galopago/PANEL_MOUNT_7_SEGMENTS_DISPLAY/README.md

# PANEL MOUNT 7 SEGMENT SERIALLY CONTROLED LED DISPLAYS

Open source 7 segment serially controlled led display that fits inside a generic 45x26mm panel mount plastic enclosure. Upgrade your function specific panel meter PCB with a new one controllable by your preferred MCU.

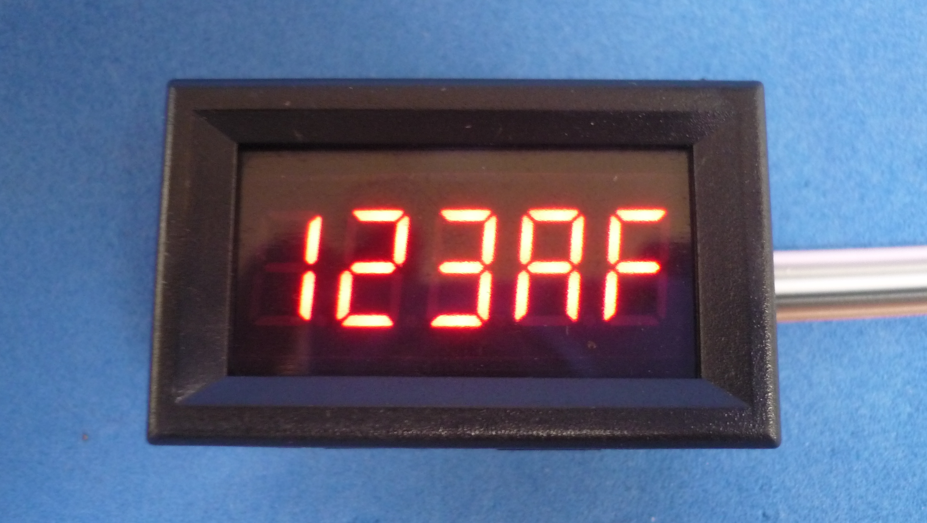
[picture p1: 036-inch-5-digit/assets/img/meteron.jpg]
METERON


Read this in other languages: [Español](/assets/markdown/README.es.md)

Upgrading a 5 digit voltmeter PCB with a 5 digit serially controllable display

0.36 Inch 5 Digits voltmeter                  | 0.36 Inch 5 Digits serially controllable     
----------------------------------------------|----------------------------------------------
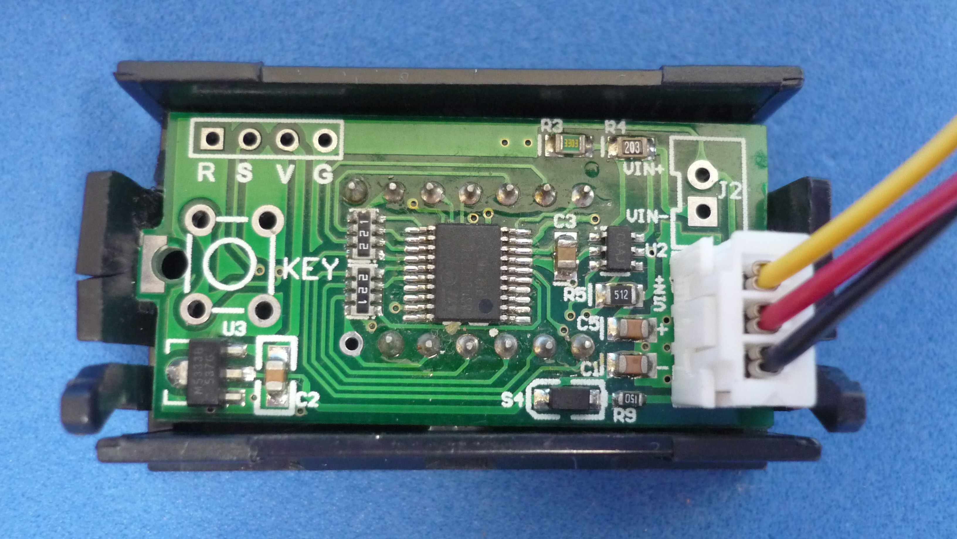
[picture p2: assets/img/voltmeterback.jpg]
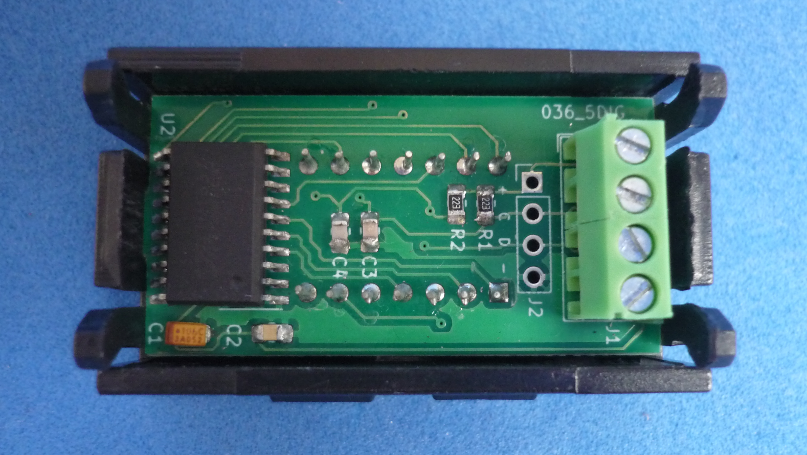
[picture p3: 036-inch-5-digit/assets/img/meterback.jpg]
            | 
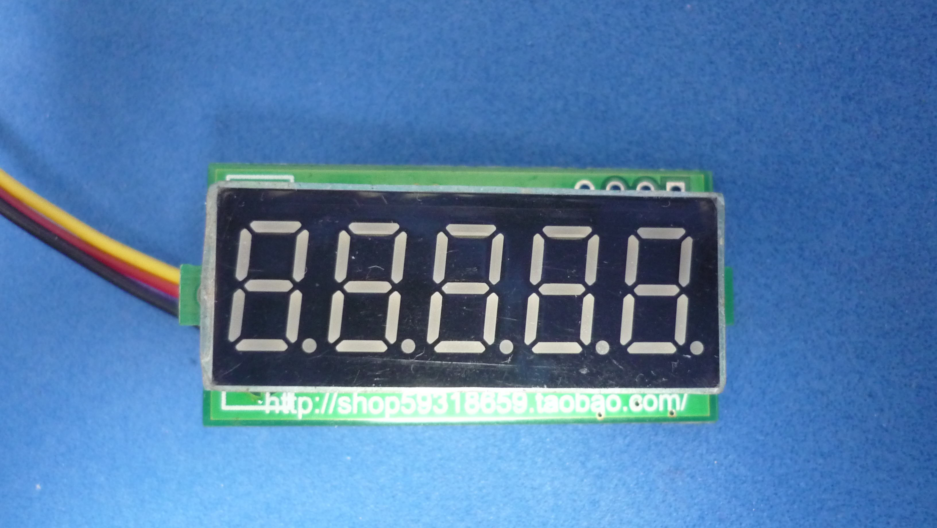
[picture p4: assets/img/voltmeterpcbfront.jpg]
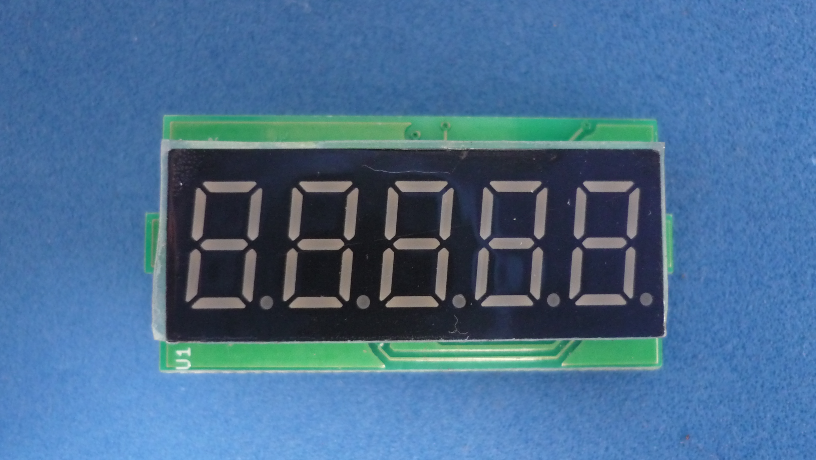
[picture p5: 036-inch-5-digit/assets/img/pcbfront.jpg]
        | 
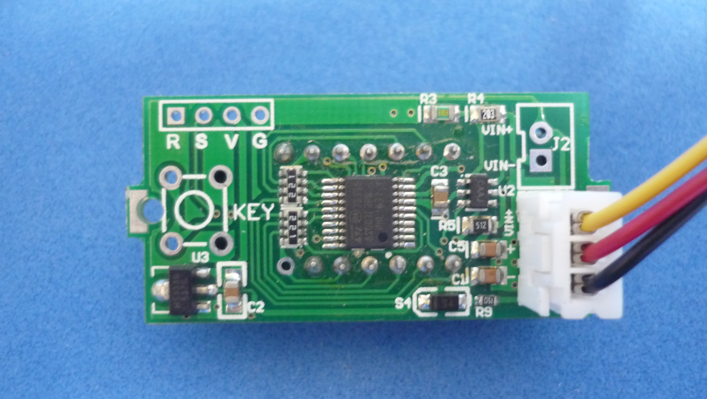
[picture p6: assets/img/voltmeterpcbback.jpg]
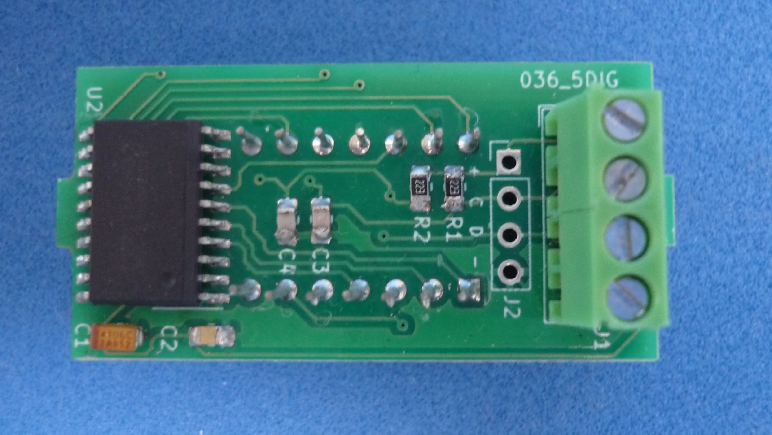
[picture p7: 036-inch-5-digit/assets/img/pcbback.jpg]
         | 

The display can be now controlled by Arduino (or any other) boards via serial bus, to display numbers, letters, or individual segments.

## Versions

There are several board versions, each one with different personalities

| HINT | CONTROLLER CHIP | LINK 
|---|---|---
| 056 INCH 3 DIGIT | TM1637 | [056 INCH 3 DIGIT](/056-inch-3-digit)  
| 036 INCH 5 DIGIT | TM1637 | [036 INCH 5 DIGIT](/036-inch-5-digit)  
| 028 INCH 8 DIGIT (2 Lines x 4Digit)| MAX7219 | [028 INCH 8 DIGIT](/028-inch-8-digit)

0.56 Inch 3 Digits                            | 0.36 Inch 5 Digits                            | 0.28 Inch 8 Digits 
----------------------------------------------|-----------------------------------------------|----------------------------------------------
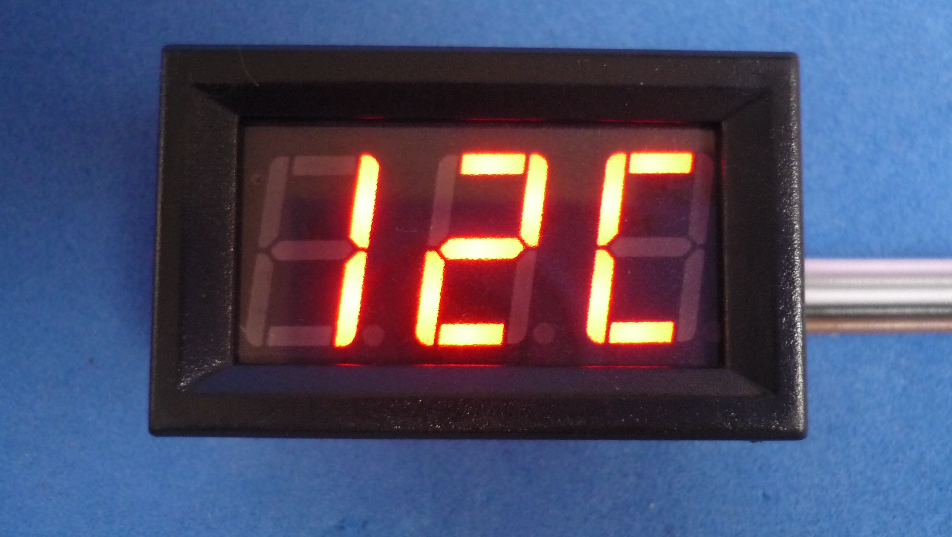
[picture p8: 056-inch-3-digit/assets/img/meteron.jpg]
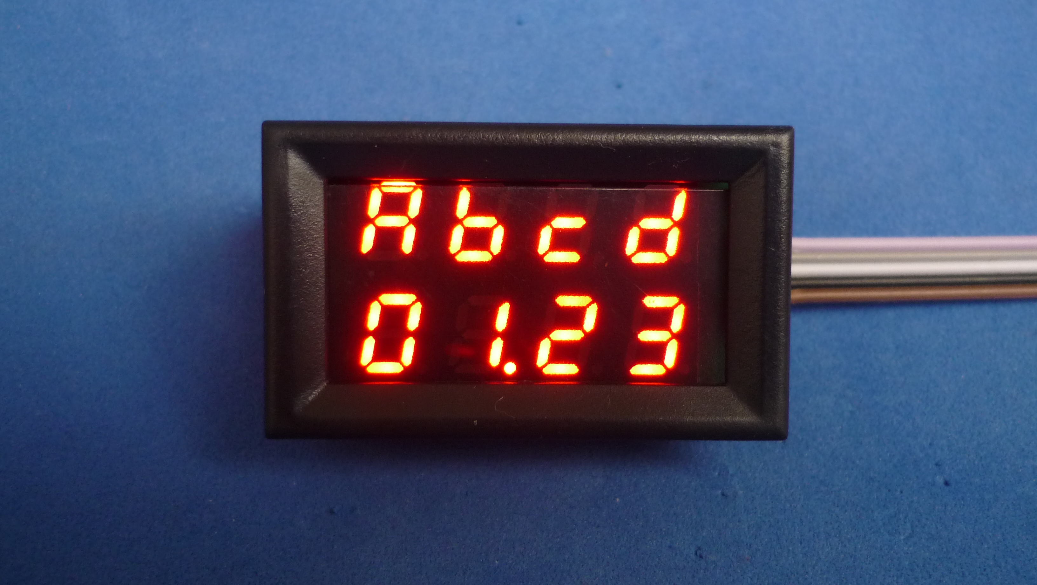
[picture p9: 028-inch-8-digit/assets/img/meteron.jpg]
 |  |
