galopago/PANEL_MOUNT_7_SEGMENTS_DISPLAY/028-inch-8-digit/assets/img/meterback.jpg

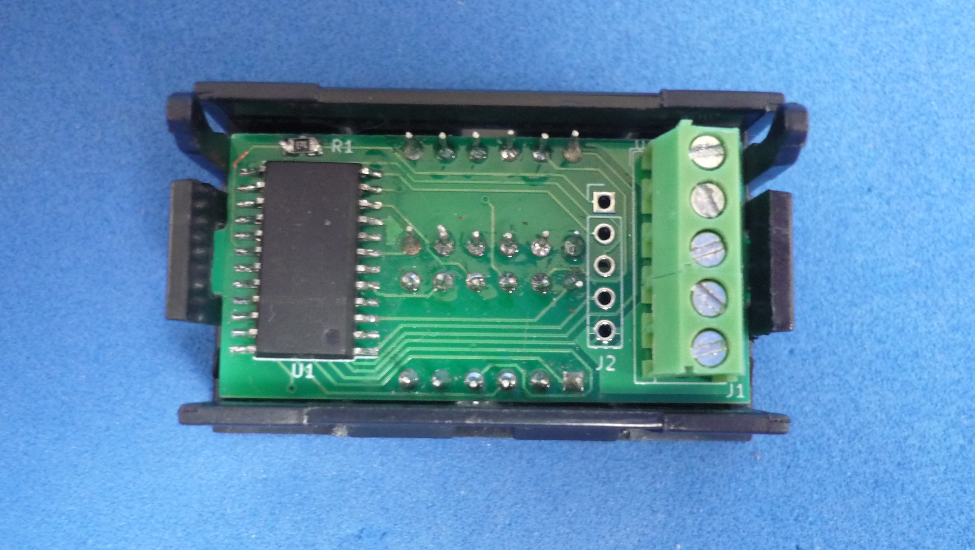
028-inch-8-digit/assets/img/meterback.jpg
