galopago/PANEL_MOUNT_7_SEGMENTS_DISPLAY/036-inch-5-digit/assets/img/meterfront.jpg

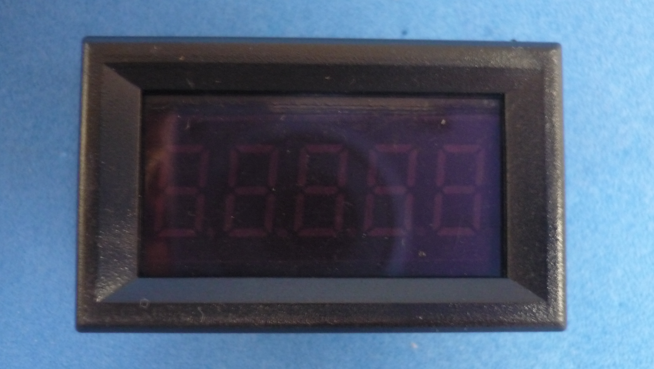
036-inch-5-digit/assets/img/meterfront.jpg
