galopago/PANEL_MOUNT_7_SEGMENTS_DISPLAY/056-inch-3-digit/assets/img/meterback.jpg

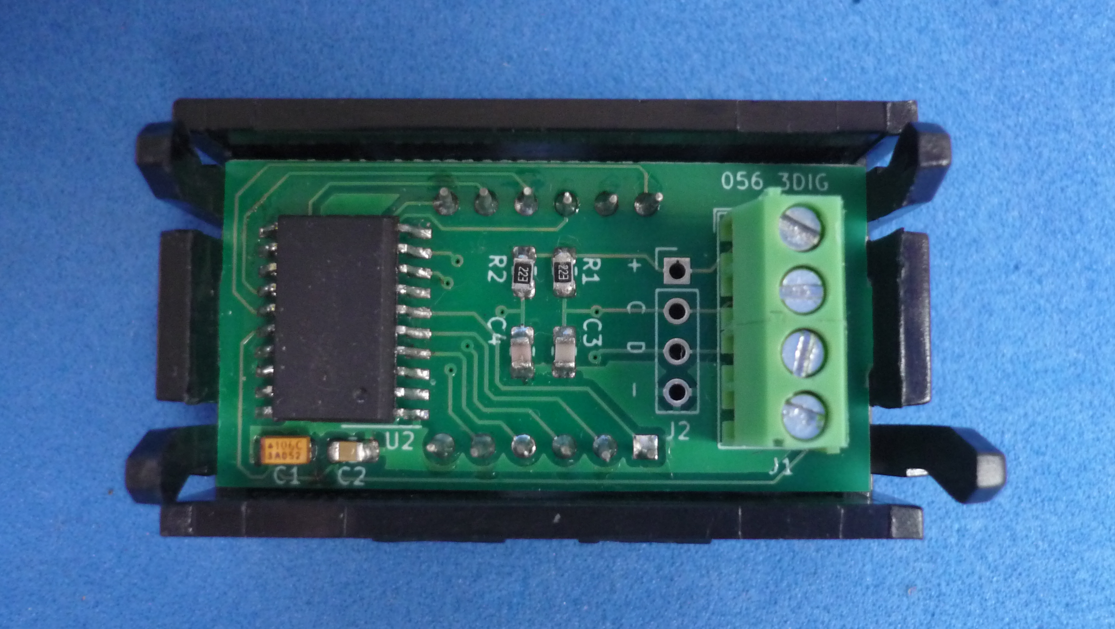
056-inch-3-digit/assets/img/meterback.jpg
