galopago/PANEL_MOUNT_7_SEGMENTS_DISPLAY/(list of files, drawings)

Other design files:
028-inch-8-digit/routing/028INCH_8DIGIT.dsn
