galopago/PANEL_MOUNT_7_SEGMENTS_DISPLAY/028-inch-8-digit/028INCH_8DIGIT.kicad_pcb

## KiCad design 028-inch-8-digit/028INCH_8DIGIT.kicad_pcb (2021-11-16)

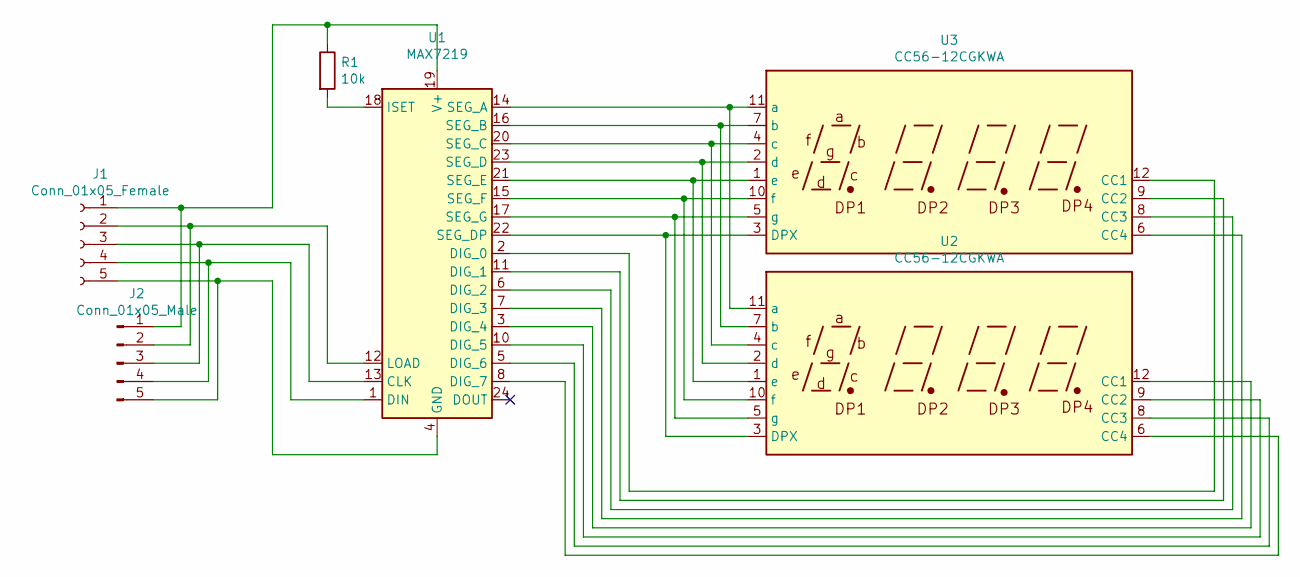
[picture p22: schematic 028INCH_8DIGIT.sch]

Parts:
J1: Conn_01x05_Female; TerminalBlock_4Ucon_1x05_P3.50mm_Horizontal
J2: Conn_01x05_Male; PinHeader_1x05_P2.54mm_Vertical
R1: 10k; R_0805_2012Metric_Pad1.15x1.40mm_HandSolder
U1: MAX7219; SOIC-24W_7.5x15.4mm_P1.27mm
U2, U3: CC56-12CGKWA; 2841AS

Connections:
unnamed: J1.1, J2.1, R1.1, U1.19 (V+)
unnamed: J1.2, J2.2, U1.12 (LOAD)
unnamed: J1.3, J2.3, U1.13 (CLK)
unnamed: J1.4, J2.4, U1.1 (DIN)
unnamed: J1.5, J2.5, U1.4 (GND), U1.9 (GND)
unnamed: R1.2, U1.18 (ISET)
unnamed: U1.2 (DIG_0), U3.12 (CC1)
unnamed: U1.3 (DIG_4), U2.12 (CC1)
unnamed: U1.5 (DIG_6), U2.8 (CC3)
unnamed: U1.6 (DIG_2), U3.8 (CC3)
unnamed: U1.7 (DIG_3), U3.6 (CC4)
unnamed: U1.8 (DIG_7), U2.6 (CC4)
unnamed: U1.10 (DIG_5), U2.9 (CC2)
unnamed: U1.11 (DIG_1), U3.9 (CC2)
unnamed: U1.14 (SEG_A), U2.11 (a), U3.11 (a)
unnamed: U1.15 (SEG_F), U2.10 (f), U3.10 (f)
unnamed: U1.16 (SEG_B), U2.7 (b), U3.7 (b)
unnamed: U1.17 (SEG_G), U2.5 (g), U3.5 (g)
unnamed: U1.20 (SEG_C), U2.4 (c), U3.4 (c)
unnamed: U1.21 (SEG_E), U2.1 (e), U3.1 (e)
unnamed: U1.22 (SEG_DP), U2.3 (DPX), U3.3 (DPX)
unnamed: U1.23 (SEG_D), U2.2 (d), U3.2 (d)

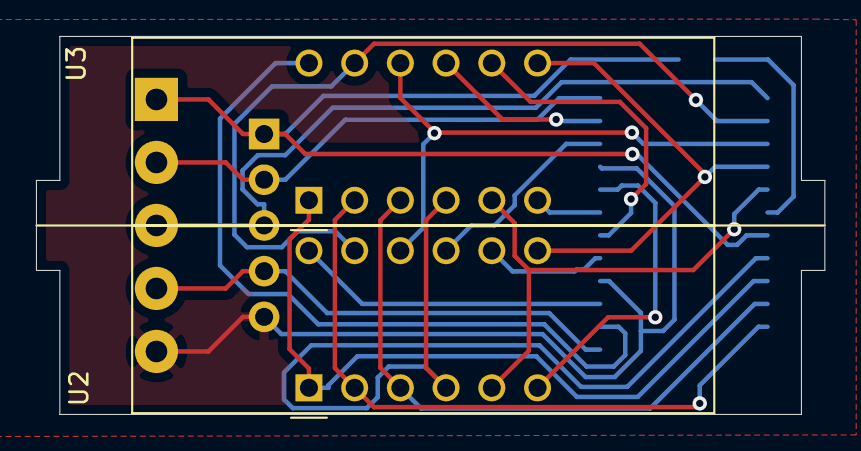
[picture p23: board 028INCH_8DIGIT.kicad_pcb from above]

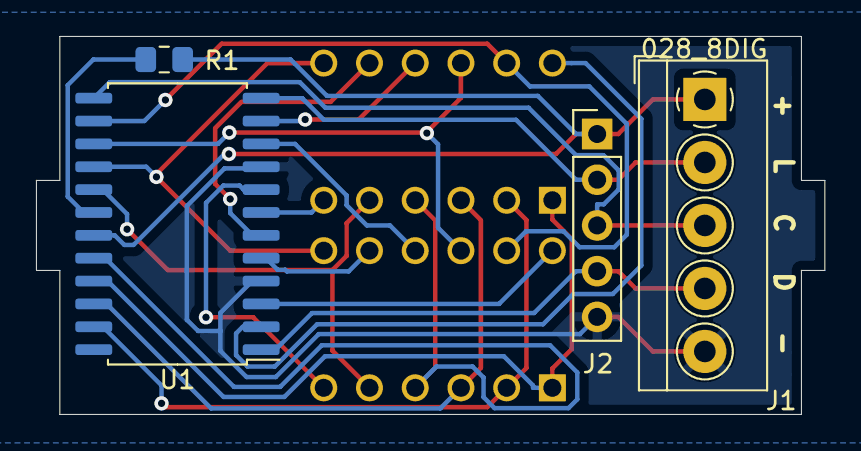
[picture p24: board 028INCH_8DIGIT.kicad_pcb from below]

Board: 2 copper layers, 43.8 x 21.0 mm, 6 parts (4 on the bottom side), 22 nets.
