galopago/PANEL_MOUNT_7_SEGMENTS_DISPLAY/036-inch-5-digit/036INCH_5DIGIT.kicad_pcb

## KiCad design 036-inch-5-digit/036INCH_5DIGIT.kicad_pcb (2021-11-16)

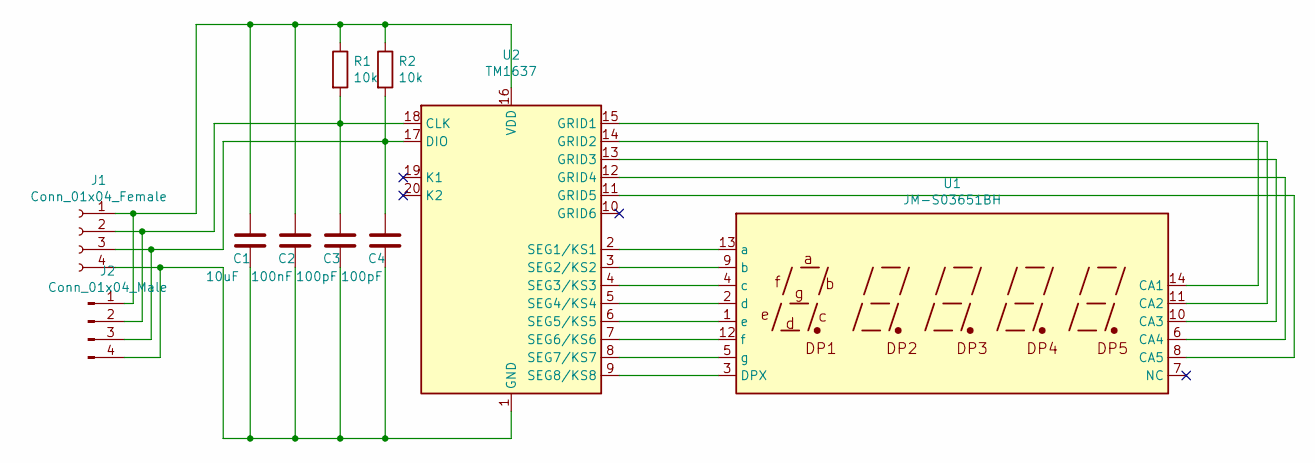
[picture p25: schematic 036INCH_5DIGIT.sch]

Parts:
C1: 10uF; C_0805_2012Metric_Pad1.15x1.40mm_HandSolder
C2: 100nF; C_0805_2012Metric_Pad1.15x1.40mm_HandSolder
C3, C4: 100pF; C_0805_2012Metric_Pad1.15x1.40mm_HandSolder
J1: Conn_01x04_Female; TerminalBlock_4Ucon_1x04_P3.50mm_Horizontal
J2: Conn_01x04_Male; PinHeader_1x04_P2.54mm_Vertical
R1, R2: 10k; R_0805_2012Metric_Pad1.15x1.40mm_HandSolder
U1: JM-S03651BH
U2: TM1637; SO-20_12.8x7.5mm_P1.27mm

Connections:
unnamed: C1.1, C2.1, J1.1, J2.1, R1.1, R2.1, U2.16 (VDD)
unnamed: C1.2, C2.2, C3.2, C4.2, J1.4, J2.4, U2.1 (GND)
unnamed: C3.1, J1.2, J2.2, R1.2, U2.18 (CLK)
unnamed: C4.1, J1.3, J2.3, R2.2, U2.17 (DIO)
unnamed: U1.1 (e), U2.6 (SEG5/KS5)
unnamed: U1.2 (d), U2.5 (SEG4/KS4)
unnamed: U1.3 (DPX), U2.9 (SEG8/KS8)
unnamed: U1.4 (c), U2.4 (SEG3/KS3)
unnamed: U1.5 (g), U2.8 (SEG7/KS7)
unnamed: U1.6 (CA4), U2.12 (GRID4)
unnamed: U1.8 (CA5), U2.11 (GRID5)
unnamed: U1.9 (b), U2.3 (SEG2/KS2)
unnamed: U1.10 (CA3), U2.13 (GRID3)
unnamed: U1.11 (CA2), U2.14 (GRID2)
unnamed: U1.12 (f), U2.7 (SEG6/KS6)
unnamed: U1.13 (a), U2.2 (SEG1/KS1)
unnamed: U1.14 (CA1), U2.15 (GRID1)

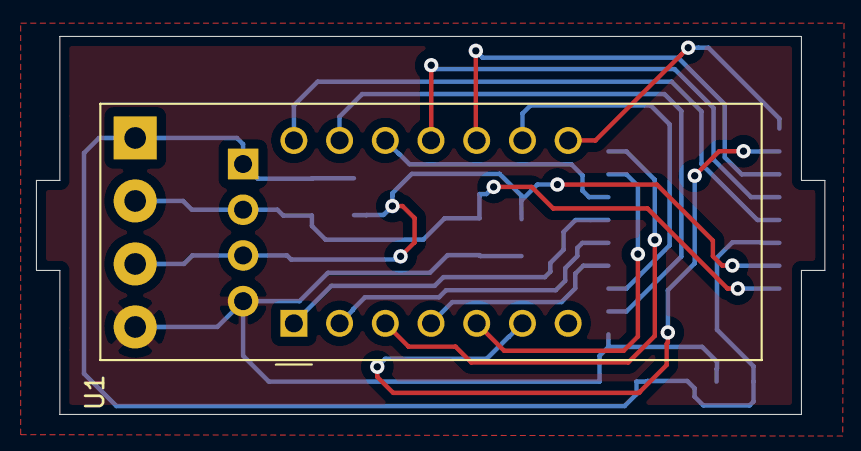
[picture p26: board 036INCH_5DIGIT.kicad_pcb from above]

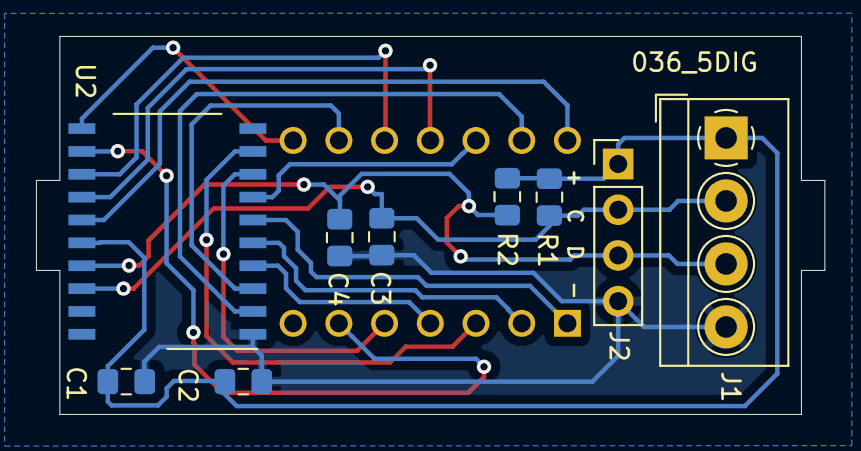
[picture p27: board 036INCH_5DIGIT.kicad_pcb from below]

Board: 2 copper layers, 43.8 x 21.0 mm, 10 parts (9 on the bottom side), 17 nets.
