galopago/PANEL_MOUNT_7_SEGMENTS_DISPLAY/(commit log)

2021-11-11 board outline dimensions finished
    [056INCH_3DIGIT.kicad_pcb, 056INCH_3DIGIT.sch]
2021-11-12 halfway 3 digit display symbol
    [056INCH_3DIGIT.kicad_pcb, 056INCH_3DIGIT.sch]
2021-11-12 3 digit display symbol & footprint finished
    [056INCH_3DIGIT.kicad_pcb, 056INCH_3DIGIT.sch]
2021-11-12 TM1637 symbol finished
    [056INCH_3DIGIT.kicad_pcb, 056INCH_3DIGIT.sch]
2021-11-12 first connections schematic
    [056INCH_3DIGIT.kicad_pcb, 056INCH_3DIGIT.sch]
2021-11-12 all traces routed
    [056INCH_3DIGIT.kicad_pcb, 056INCH_3DIGIT.sch]
2021-11-12 jingmei display symbol started
    [036INCH_5DIGIT.kicad_pcb, 036INCH_5DIGIT.sch]
2021-11-12 jingmei display symbol finished
    [036INCH_5DIGIT.sch]
2021-11-13 jingmei display footprint finished
2021-11-13 starting placing elements in pcb
    [036INCH_5DIGIT.kicad_pcb, 036INCH_5DIGIT.sch]
2021-11-13 4 digit 0.28 inch display footprint finished
    [028INCH_8DIGIT.kicad_pcb, 028INCH_8DIGIT.sch]
2021-11-13 start element placing
    [028INCH_8DIGIT.kicad_pcb, 028INCH_8DIGIT.sch]
2021-11-13 all elements placed
    [028INCH_8DIGIT.kicad_pcb]
2021-11-16 single board gerber
    [056INCH_3DIGIT-B_Cu.gbr, 056INCH_3DIGIT-B_Mask.gbr, 056INCH_3DIGIT-B_SilkS.gbr, 056INCH_3DIGIT-Edge_Cuts.gbr, 056INCH_3DIGIT-F_Cu.gbr, 056INCH_3DIGIT-F_Mask.gbr, 056INCH_3DIGIT-F_SilkS.gbr, 056INCH_3DIGIT-NPTH.drl]
2021-11-16 panel board gerber
    [056INCH_3DIGIT_PANEL-B_Cu.gbr, 056INCH_3DIGIT_PANEL-B_Mask.gbr, 056INCH_3DIGIT_PANEL-B_SilkS.gbr, 056INCH_3DIGIT_PANEL-Edge_Cuts.gbr, 056INCH_3DIGIT_PANEL-F_Cu.gbr, 056INCH_3DIGIT_PANEL-F_Mask.gbr, 056INCH_3DIGIT_PANEL-F_SilkS.gbr, 056INCH_3DIGIT_PANEL-NPTH.drl]
2022-03-13 doc:(panel-mount-7-segments-display ROOT)renamed folders
    [028INCH_8DIGIT-B_Cu.gbr, 028INCH_8DIGIT-B_Mask.gbr, 028INCH_8DIGIT-B_SilkS.gbr, 028INCH_8DIGIT-Edge_Cuts.gbr, 028INCH_8DIGIT-F_Cu.gbr, 028INCH_8DIGIT-F_Mask.gbr, 028INCH_8DIGIT-F_SilkS.gbr, 028INCH_8DIGIT-NPTH.drl]
2022-03-13 doc:(panel-mount-7-segments-display ROOT)renamed folders+
    [028INCH_8DIGIT-B_Cu.gbr, 028INCH_8DIGIT-B_Mask.gbr, 028INCH_8DIGIT-B_SilkS.gbr, 028INCH_8DIGIT-Edge_Cuts.gbr, 028INCH_8DIGIT-F_Cu.gbr, 028INCH_8DIGIT-F_Mask.gbr, 028INCH_8DIGIT-F_SilkS.gbr, 028INCH_8DIGIT-NPTH.drl]
2022-03-14 doc:(panel-mount-7-segments-display ROOT)readme+pics
2022-03-14 doc:(panel-mount-7-segments-display ROOT)readme+pics+
2022-03-14 doc:(panel-mount-7-segments-display ROOT)readme++
2022-03-14 doc:(panel-mount-7-segments-display ROOT)readme+++
2022-03-14 doc:(panel-mount-7-segments-display ROOT)readme++++
2022-03-14 doc:(panel-mount-7-segments-display ROOT)readme+++++
2022-03-14 doc:(panel-mount-7-segments-display ROOT)readme++++++
2022-03-14 doc:(panel-mount-7-segments-display ROOT)readme+++++++
2022-03-14 doc:(panel-mount-7-segments-display ROOT)readme++++++++
2022-03-14 doc:(panel-mount-7-segments-display ROOT)readme+++++++++
2022-03-14 doc:(panel-mount-7-segments-display ROOT)readme+++++++++++
2022-03-14 doc:(panel-mount-7-segments-display ROOT)readme++++++++++++
2022-03-14 doc:(panel-mount-7-segments-display ROOT)readme ES started
2022-03-14 doc:(panel-mount-7-segments-display ROOT)readme ES+
2022-03-14 doc:(panel-mount-7-segments-display ROOT)readme ES++
2022-03-14 doc:(panel-mount-7-segments-display ROOT)readme ES+++
2022-03-14 doc:(panel-mount-7-segments-display ROOT)readme ES++++
2022-03-15 doc:(panel-mount-7-segments-display 056-3-digit)readme started
2022-03-15 doc:(panel-mount-7-segments-display 056-3-digit)readme started+
2022-03-15 doc:(panel-mount-7-segments-display 056-3-digit)readme started++
2022-03-15 doc:(panel-mount-7-segments-display 056-3-digit)readme started+++
2022-03-15 doc:(panel-mount-7-segments-display 056-3-digit)readme started++++
2022-03-15 doc:(panel-mount-7-segments-display 056-3-digit)readme started+++++
2022-03-15 doc:(panel-mount-7-segments-display 056-3-digit)readme started++++++
2022-03-15 doc:(panel-mount-7-segments-display 036-5-digit)readme started
2022-03-15 doc:(panel-mount-7-segments-display 036-5-digit)readme started+
2022-03-15 doc:(panel-mount-7-segments-display 036-5-digit)changed pic
2022-03-15 doc:(panel-mount-7-segments-display 036-3-digit)changed pic+
2022-03-15 doc:(panel-mount-7-segments-display 028-8-digit)started readme
2022-03-15 doc:(panel-mount-7-segments-display root)license
